xioTechnologies/Money-No-Object/RFID Coil Jig/Assembly Process Photos/CIMG1613.JPG

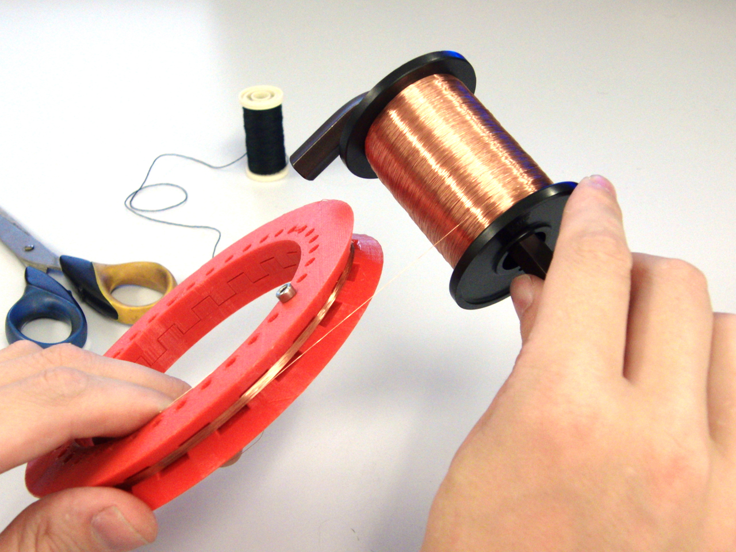
RFID Coil Jig/Assembly Process Photos/CIMG1613.JPG
