xioTechnologies/Money-No-Object/RFID Coil Jig/Assembly Process Photos/CIMG1606.JPG

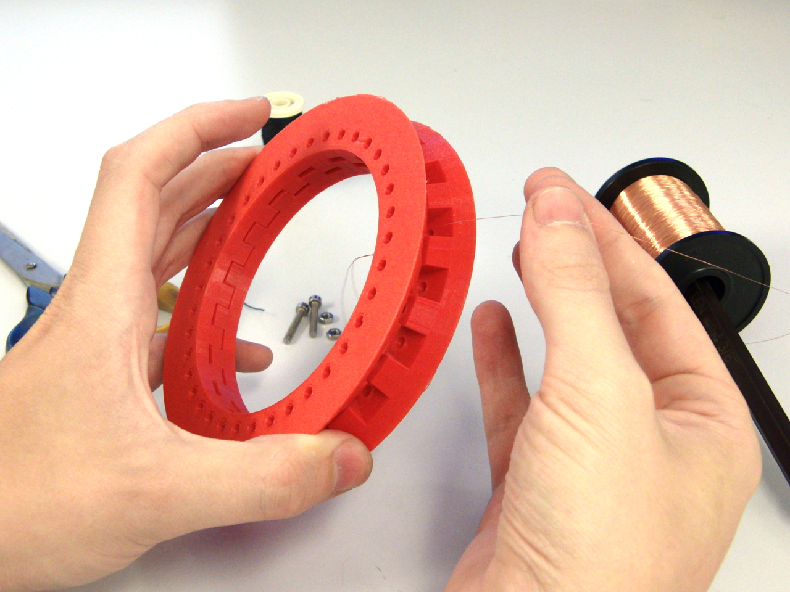
RFID Coil Jig/Assembly Process Photos/CIMG1606.JPG
