xioTechnologies/Money-No-Object/RFID Coil Jig/SolidWorks Screenshot.png

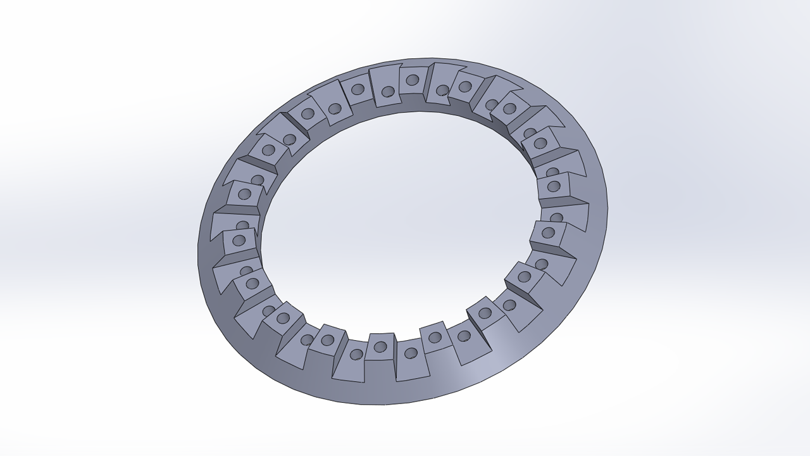
RFID Coil Jig/SolidWorks Screenshot.png
