xioTechnologies/Money-No-Object/RFID Coil Jig/RFID Coil Jig.SLDPRT

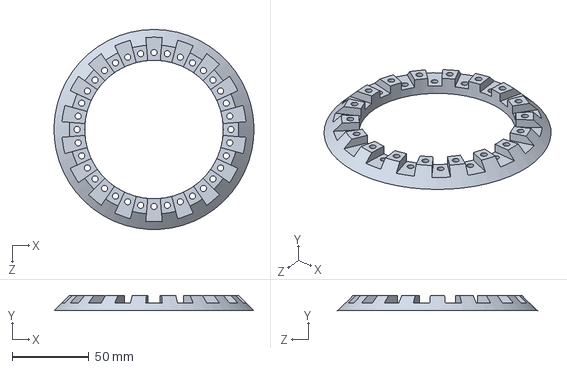
[picture p4: CAD file, 2014-08-11]
RFID Coil Jig/RFID Coil Jig.SLDPRT
129.9 x 10.0 x 130.0 mm
