xioTechnologies/Money-No-Object/(list of files, cad)

Other CAD files:
RFID Coil Jig/RFID Coil Jig.STL
