xioTechnologies/Money-No-Object/RFID Coil Jig/Assembly Process Photos/CIMG1603.JPG

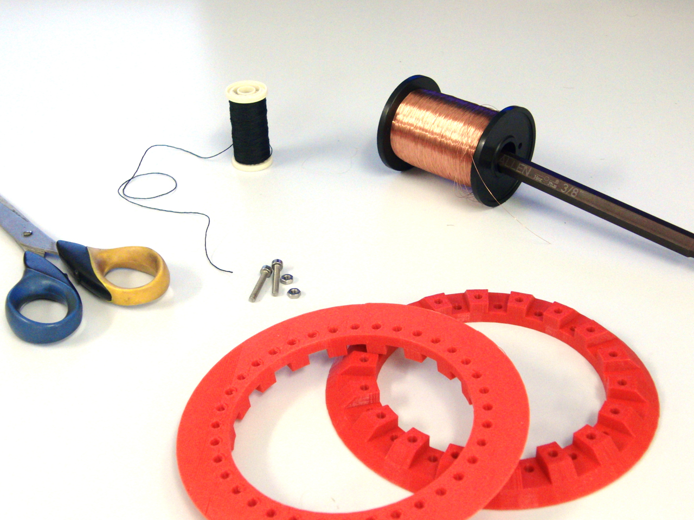
RFID Coil Jig/Assembly Process Photos/CIMG1603.JPG
