xioTechnologies/Money-No-Object/RFID Coil Jig/Assembly Process Photos/CIMG1605.JPG

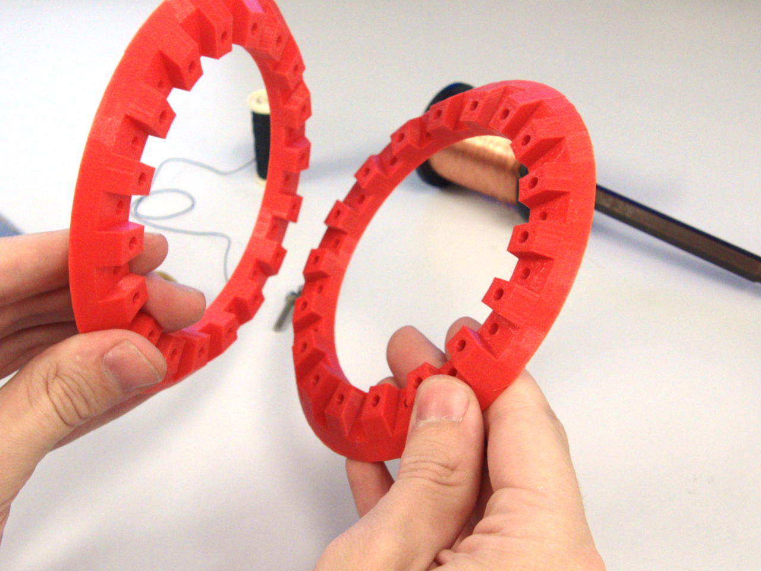
RFID Coil Jig/Assembly Process Photos/CIMG1605.JPG
