xioTechnologies/Money-No-Object/RFID Coil Jig/Assembly Process Photos/CIMG1609.JPG

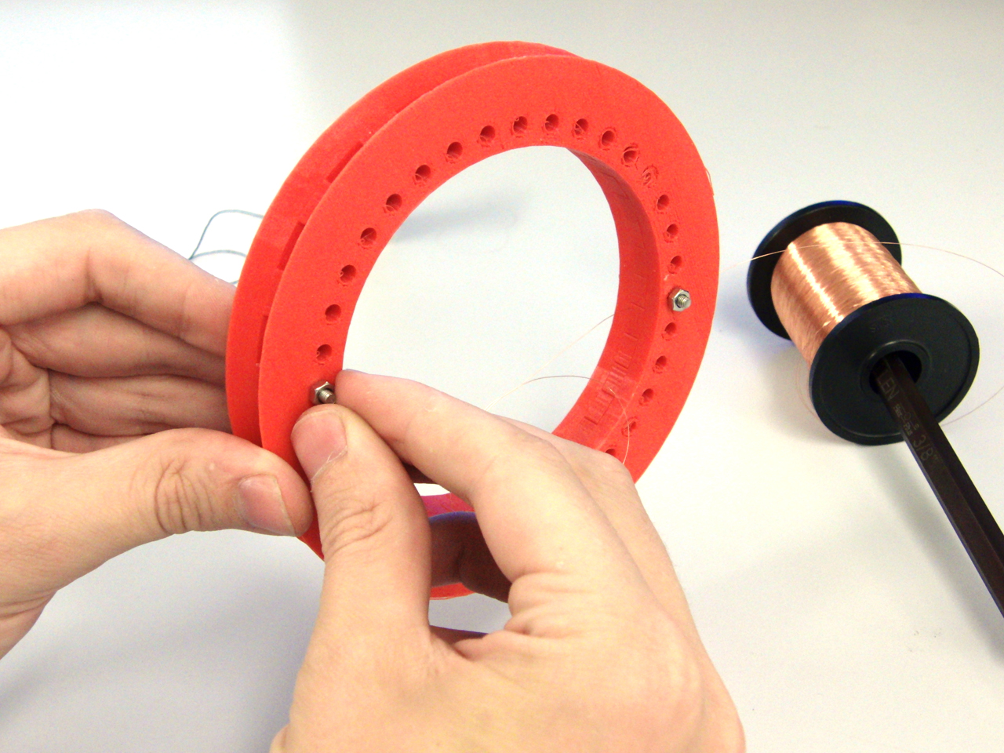
RFID Coil Jig/Assembly Process Photos/CIMG1609.JPG
