xioTechnologies/Money-No-Object/RFID Coil Jig/Assembly Process Photos/CIMG1616.JPG

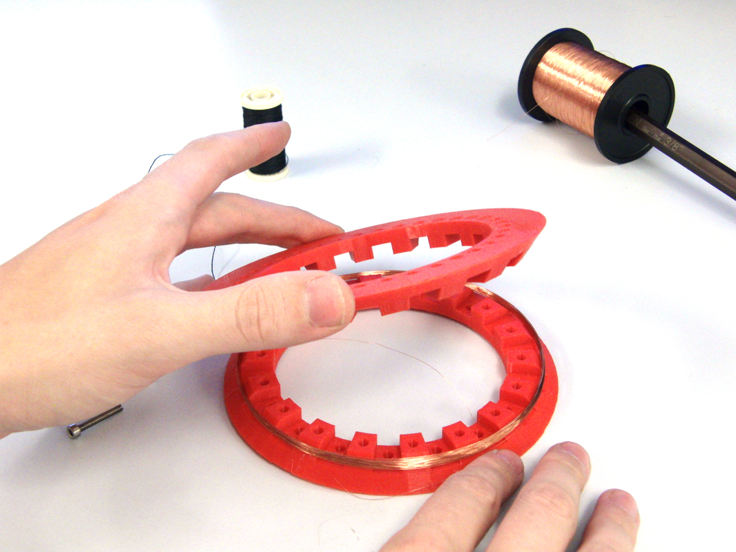
RFID Coil Jig/Assembly Process Photos/CIMG1616.JPG
