xioTechnologies/Money-No-Object/RFID Coil Jig/Assembly Process Photos/CIMG1617.JPG

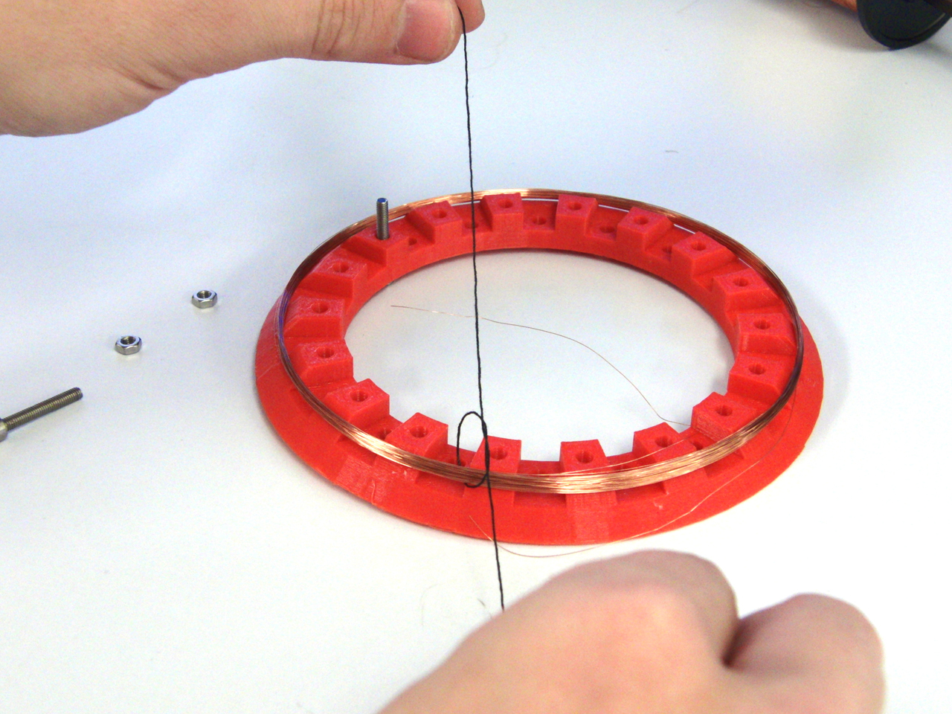
RFID Coil Jig/Assembly Process Photos/CIMG1617.JPG
