xioTechnologies/Money-No-Object/RFID Coil Jig/Assembly Process Photos/CIMG1619.JPG

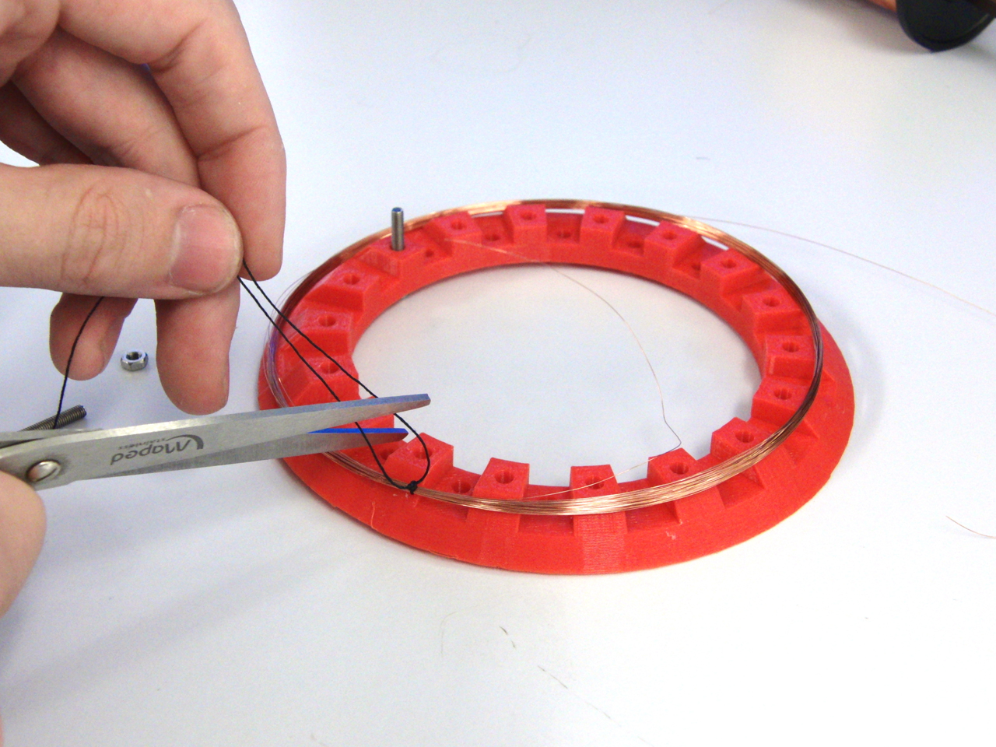
RFID Coil Jig/Assembly Process Photos/CIMG1619.JPG
