xioTechnologies/Money-No-Object/RFID Coil Jig/Assembly Process Photos/CIMG1623.JPG

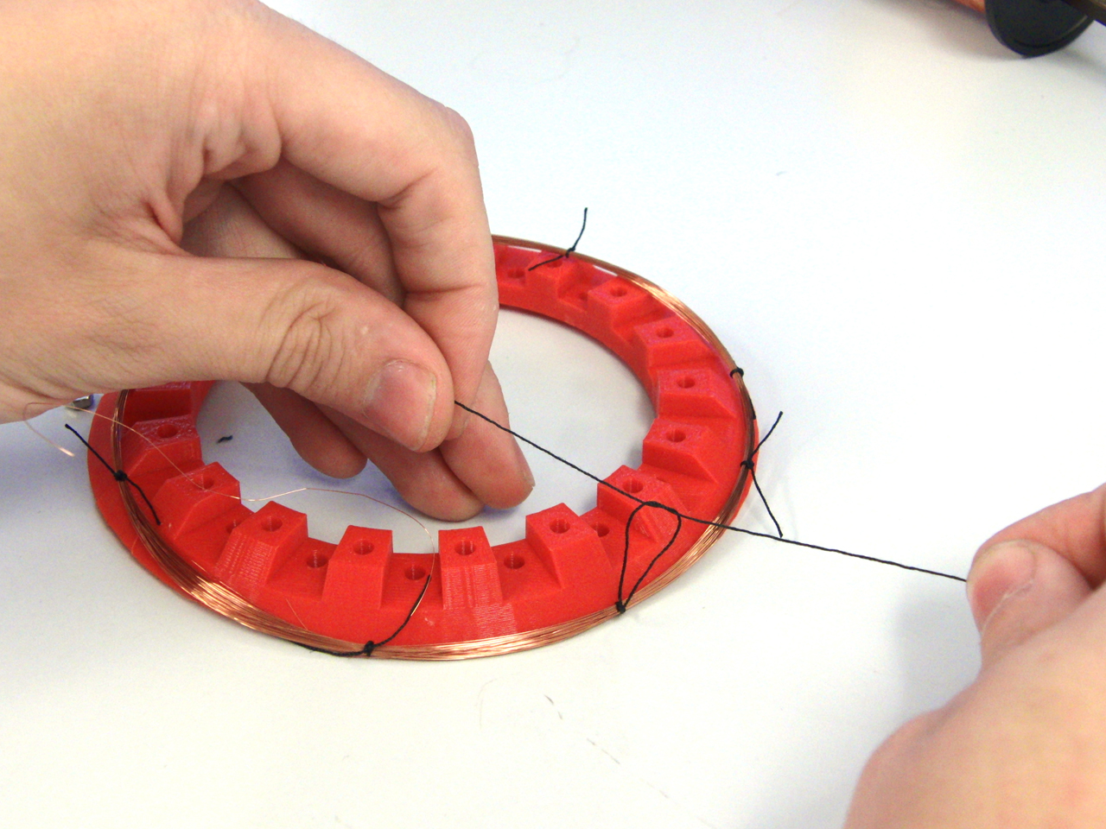
RFID Coil Jig/Assembly Process Photos/CIMG1623.JPG
