xioTechnologies/Money-No-Object/RFID Coil Jig/Assembly Process Photos/CIMG1625.JPG

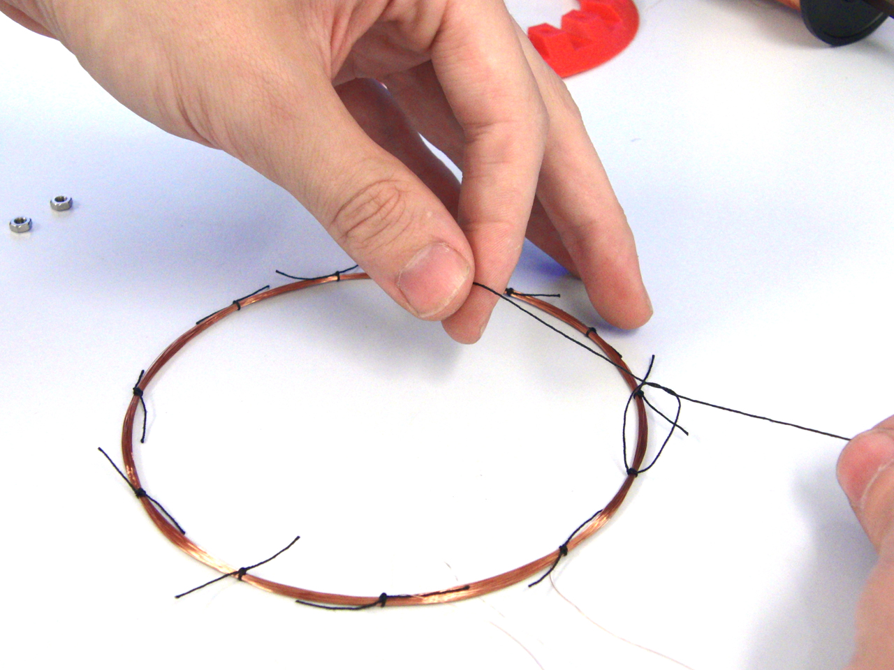
RFID Coil Jig/Assembly Process Photos/CIMG1625.JPG
