xioTechnologies/Money-No-Object/RFID Coil Jig/Assembly Process Photos/CIMG1631.JPG

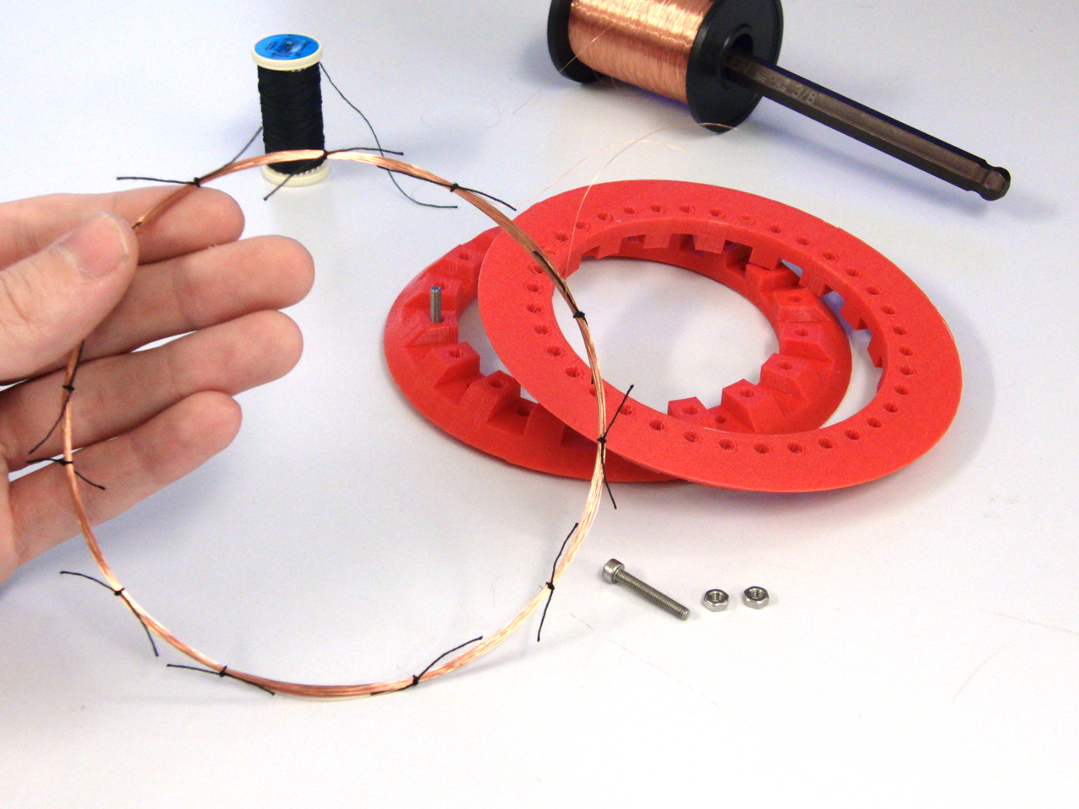
RFID Coil Jig/Assembly Process Photos/CIMG1631.JPG
