xioTechnologies/Money-No-Object/RFID Coil Jig/Assembly Process Photos/CIMG1632.JPG

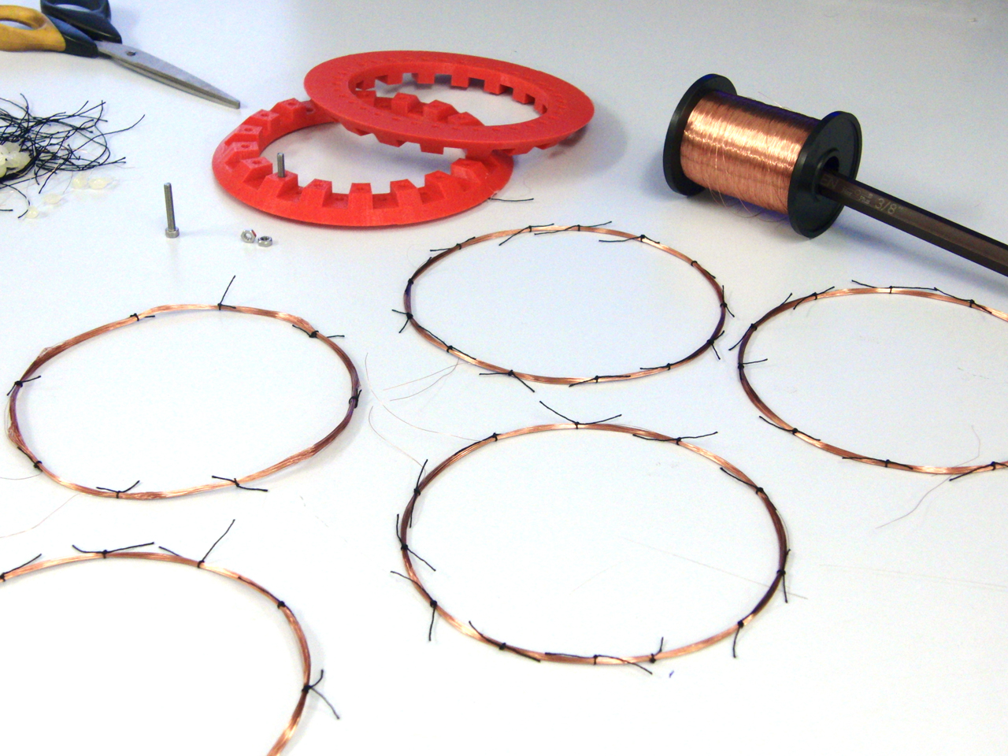
RFID Coil Jig/Assembly Process Photos/CIMG1632.JPG
