xioTechnologies/Money-No-Object/RFID Coil Jig/Assembly Process Photos/CIMG1639.JPG

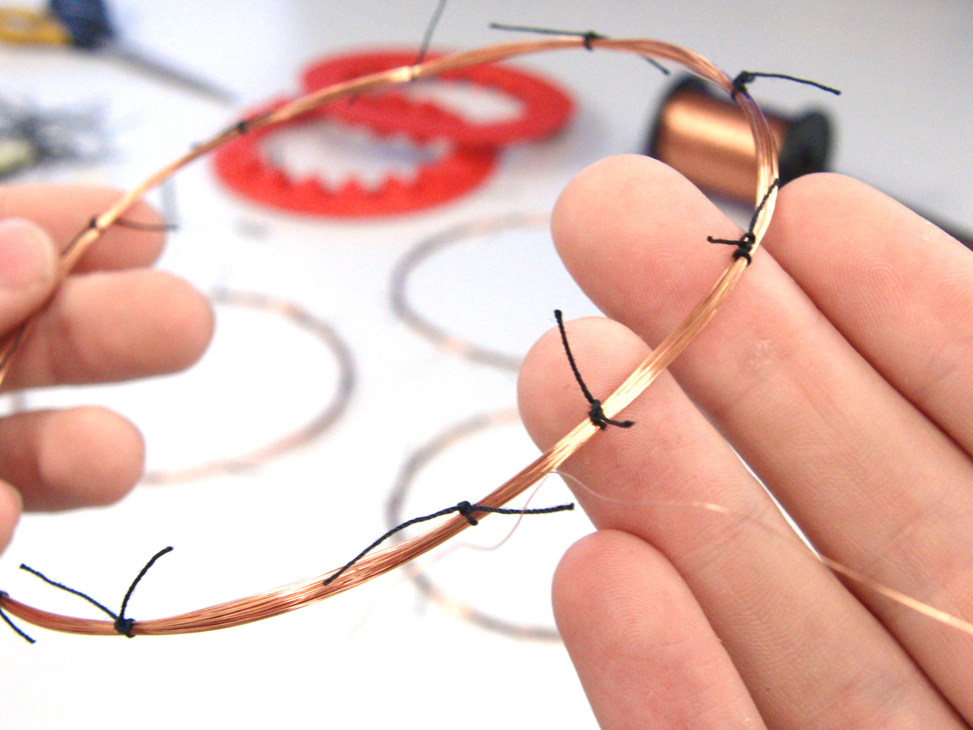
RFID Coil Jig/Assembly Process Photos/CIMG1639.JPG
