xioTechnologies/Money-No-Object/Wireless RIFID Reader PCB/Wireless RIFID Reader Schematic.pdf

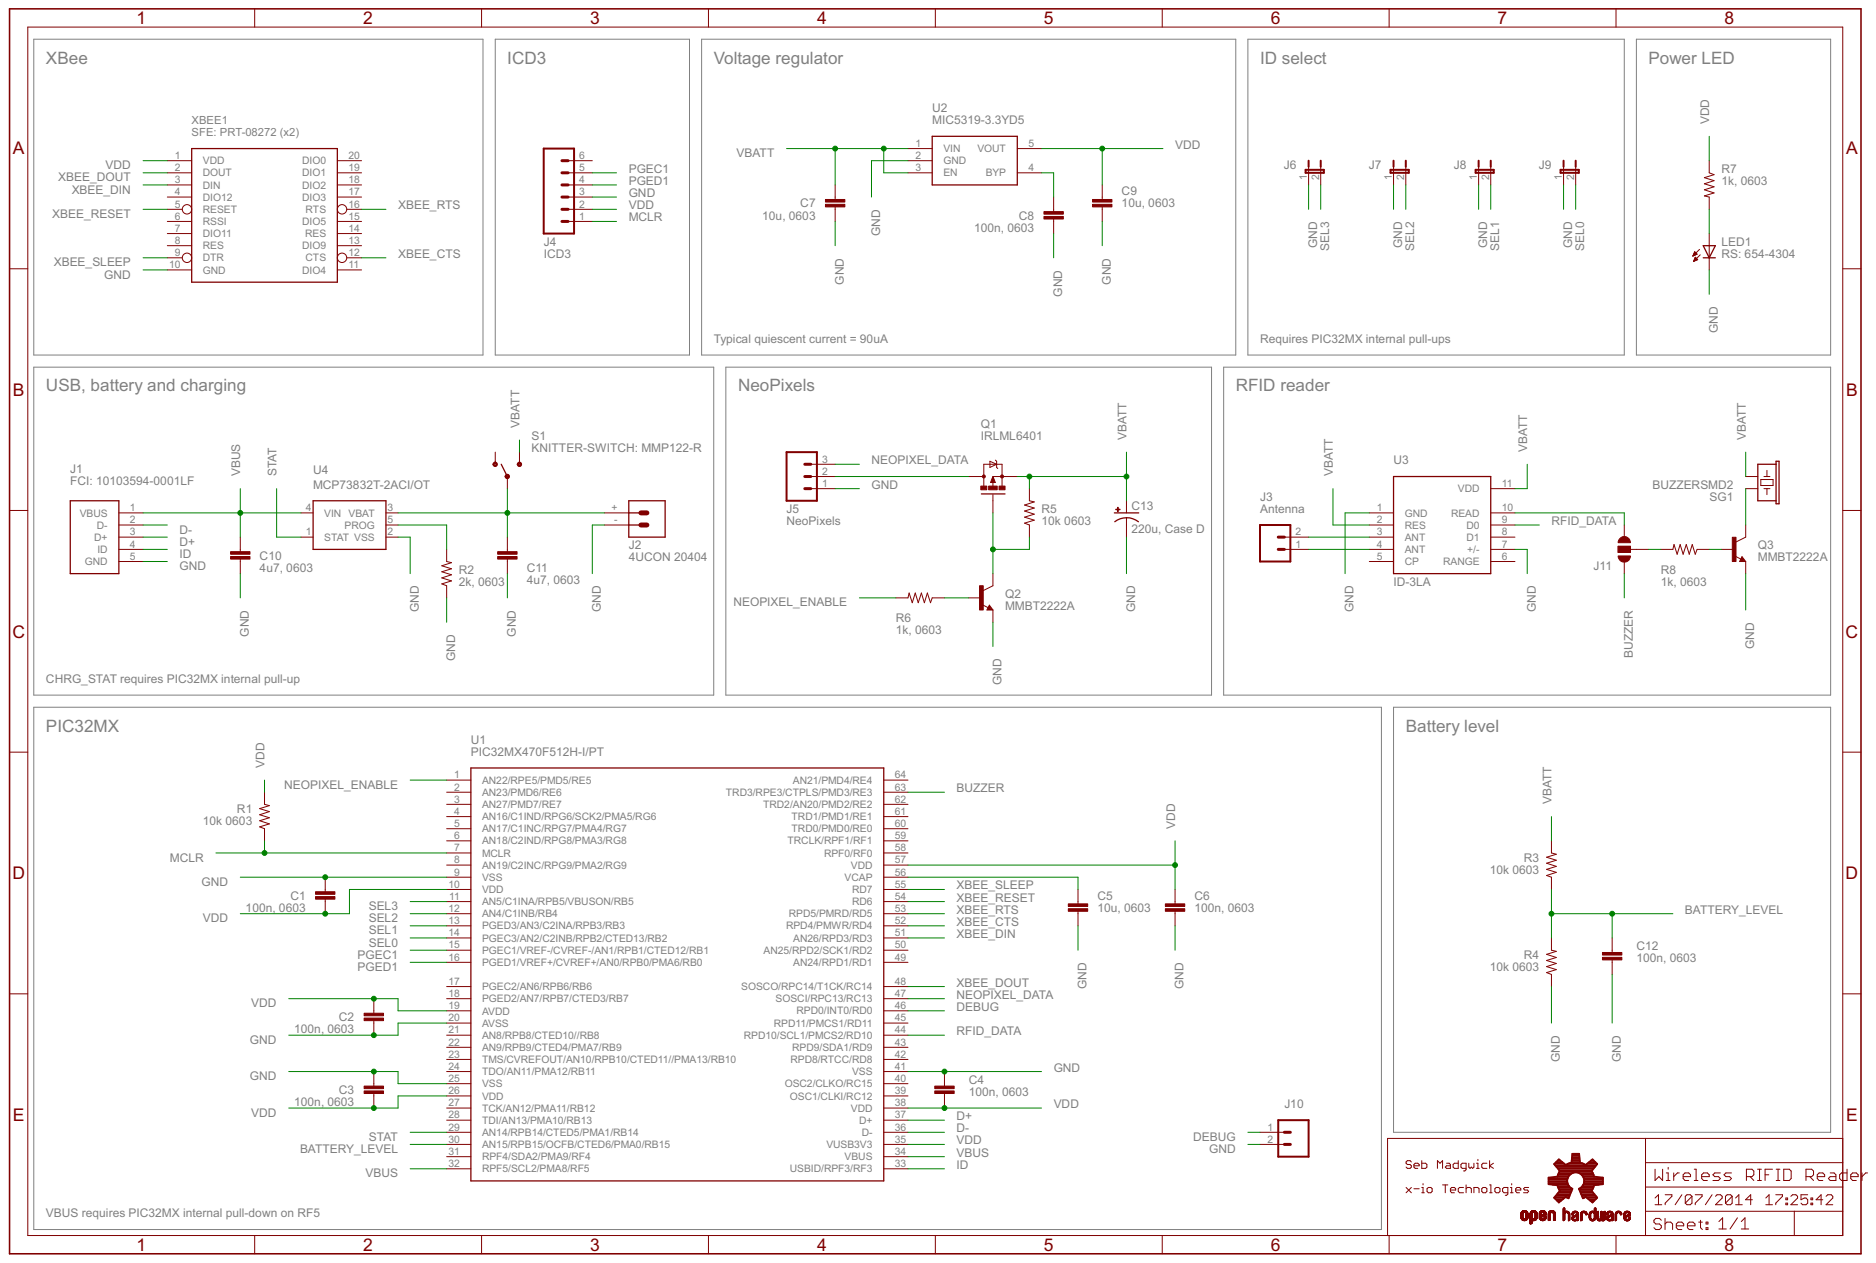
[picture p16: page 1]

GND GND

Requires PIC32MX internal pull-ups

USB, battery and charging

CHRG_STAT requires PIC32MX internal pull-up

VBUS requires PIC32MX internal pull-down on RF5
