xioTechnologies/Money-No-Object/Wireless RIFID Reader PCB/Wireless RIFID Reader.brd

## EAGLE design Wireless RIFID Reader PCB/Wireless RIFID Reader.brd (2014-07-17)

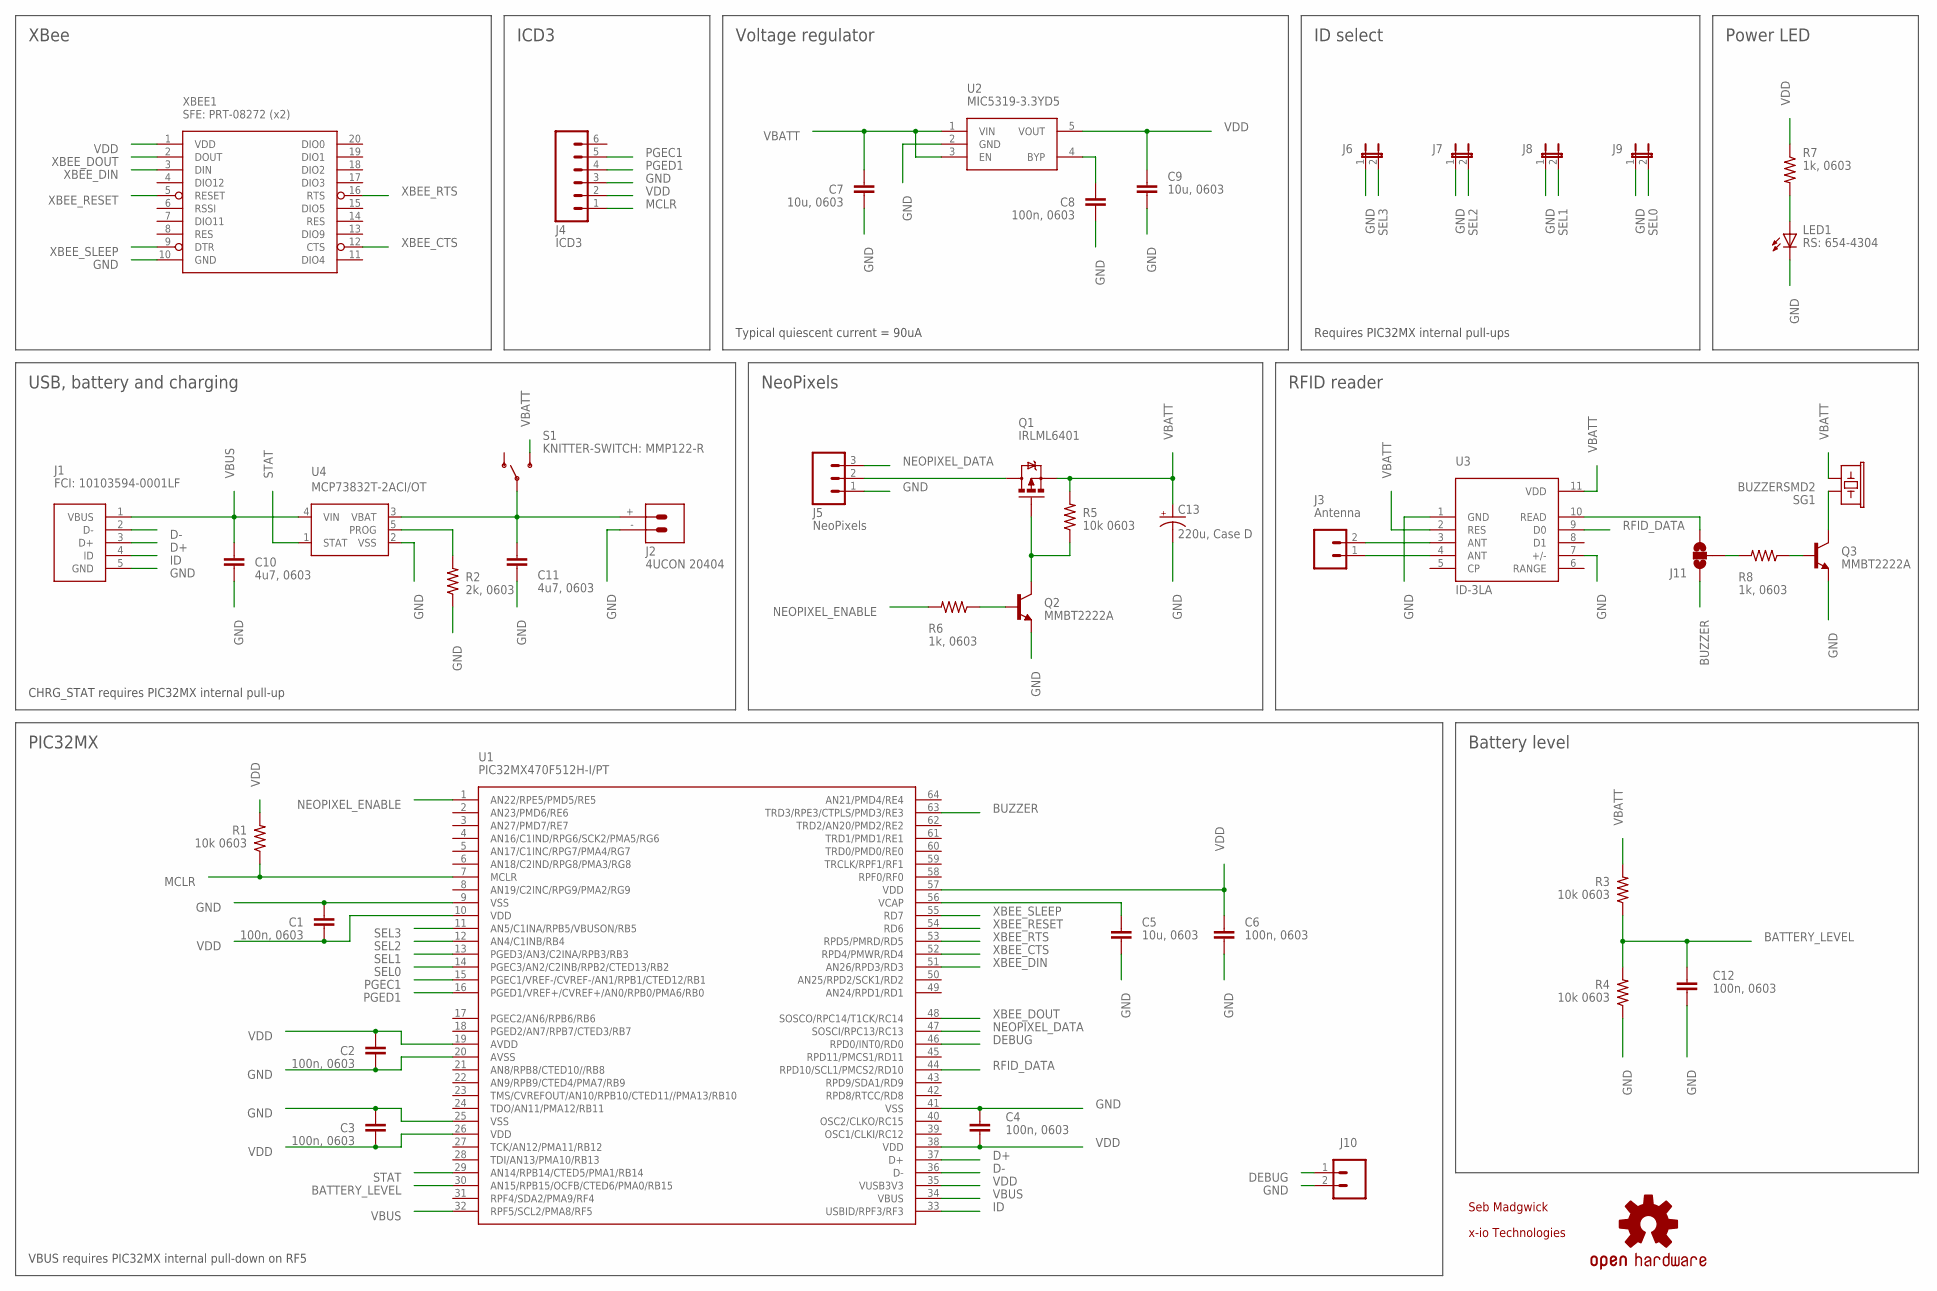
[picture p17: schematic Wireless RIFID Reader.sch]

Parts:
C1, C2, C3, C4, C6, C8, C12: 100n, 0603; 0402-CAP
C5, C7, C9: 10u, 0603; 0402-CAP
C10, C11: 4u7, 0603; 0402-CAP
C13: 220u, Case D; SMC_D
J1: FCI: 10103594-0001LF; 10103594-0001LF
J2: 4UCON 20404; JST-R/A
J3: Antenna; 1X02
J4: ICD3; 1X06_NO_SILK
J5: NeoPixels; 1X03
J6, J7, J8, J9: JUMPER-2SMD-NO; SJ_2S-NO
J10: M02PTH; 1X02
J11: JUMPER-PAD-3-NOFULL_BOX_SILK; PAD-JUMPER-3-NO_YES_SILK_FULL_BOX
LED1: RS: 654-4304; LED-0603
LOGO1: OSHW-LOGOM; OSHW-LOGO-M
Q1: IRLML6401; SOT23
Q2, Q3: MMBT2222A; SOT23-3
R1, R3, R4, R5: 10k 0603; 0402-RES
R2: 2k, 0603; 0402-RES
R6, R7, R8: 1k, 0603; 0402-RES
S1: KNITTER-SWITCH: MMP122-R; MMP122-R
SG1: BUZZERSMD2; BUZZER-CCV
U1: PIC32MX470F512H-I/PT; TQFP64-10X10
U2: MIC5319-3.3YD5; SOT23-5
U3: ID-3LA
U4: MCP73832T-2ACI/OT; SOT23-5
XBEE1: SFE: PRT-08272 (x2); XBEE-1

Connections:
BATTERY_LEVEL: C12.1, R3.1, R4.2, U1.30 (AN15/RPB15/OCFB/CTED6/PMA0/RB15)
BUZZER: J11.1, U1.63 (TRD3/RPE3/CTPLS/PMD3/RE3)
D+: J1.3 (D+), U1.37 (D+)
D-: J1.2 (D-), U1.36 (D-)
DEBUG: J10.1, U1.46 (RPD0/INT0/RD0)
GND: C1.1, C2.2, C3.1, C4.1, C5.2, C6.2, C7.2, C8.2, C9.2, C10.2, C11.2, C12.2, C13.-, J1.5 (GND), J2.-, J4.3, J5.1, J6.1, J7.1, J8.1, J9.1, J10.2, LED1.C, Q2.2 (E), Q3.2 (E), R2.1, R4.1, U1.9 (VSS), U1.20 (AVSS), U1.25 (VSS), U1.41 (VSS), U2.2 (GND), U3.1 (GND), U3.7 (+/-), U4.2 (VSS), XBEE1.10 (GND)
ID: J1.4 (ID), U1.33 (USBID/RPF3/RF3)
MCLR: J4.1, R1.1, U1.7 (MCLR)
unnamed: J3.2, U3.3 (ANT)
unnamed: J3.1, U3.4 (ANT)
unnamed: C11.1, J2.+, S1.2, U4.3 (VBAT)
unnamed: J5.2, Q1.3 (D)
unnamed: Q1.1 (G), Q2.3 (C), R5.1
unnamed: Q2.1 (B), R6.1
unnamed: C8.1, U2.4 (BYP)
unnamed: R2.2, U4.5 (PROG)
unnamed: LED1.A, R7.2
unnamed: Q3.1 (B), R8.1
unnamed: C5.1, U1.56 (VCAP)
unnamed: Q3.3 (C), SG1.+ (1)
unnamed: J11.3, U3.10 (READ)
unnamed: J11.2, R8.2
NEOPIXEL_DATA: J5.3, U1.47 (SOSCI/RPC13/RC13)
NEOPIXEL_ENABLE: R6.2, U1.1 (AN22/RPE5/PMD5/RE5)
PGEC1: J4.5, U1.15 (PGEC1/VREF-/CVREF-/AN1/RPB1/CTED12/RB1)
PGED1: J4.4, U1.16 (PGED1/VREF+/CVREF+/AN0/RPB0/PMA6/RB0)
RFID_DATA: U1.44 (RPD10/SCL1/PMCS2/RD10), U3.9 (D0)
SEL0: J9.2, U1.14 (PGEC3/AN2/C2INB/RPB2/CTED13/RB2)
SEL1: J8.2, U1.13 (PGED3/AN3/C2INA/RPB3/RB3)
SEL2: J7.2, U1.12 (AN4/C1INB/RB4)
SEL3: J6.2, U1.11 (AN5/C1INA/RPB5/VBUSON/RB5)
STAT: U1.29 (AN14/RPB14/CTED5/PMA1/RB14), U4.1 (STAT)
VBATT: C7.1, C13.+, Q1.2 (S), R3.2, R5.2, S1.3, SG1.- (2), U2.1 (VIN), U2.3 (EN), U3.2 (RES), U3.11 (VDD)
VBUS: C10.1, J1.1 (VBUS), U1.32 (RPF5/SCL2/PMA8/RF5), U1.34 (VBUS), U4.4 (VIN)
VDD: C1.2, C2.1, C3.2, C4.2, C6.1, C9.1, J4.2, R1.2, R7.1, U1.10 (VDD), U1.19 (AVDD), U1.26 (VDD), U1.35 (VUSB3V3), U1.38 (VDD), U1.57 (VDD), U2.5 (VOUT), XBEE1.1 (VDD)
XBEE_CTS: U1.52 (RPD4/PMWR/RD4), XBEE1.12 (CTS)
XBEE_DIN: U1.51 (AN26/RPD3/RD3), XBEE1.3 (DIN)
XBEE_DOUT: U1.48 (SOSCO/RPC14/T1CK/RC14), XBEE1.2 (DOUT)
XBEE_RESET: U1.54 (RD6), XBEE1.5 (RESET)
XBEE_RTS: U1.53 (RPD5/PMRD/RD5), XBEE1.16 (RTS)
XBEE_SLEEP: U1.55 (RD7), XBEE1.9 (DTR)

Notes on the sheet:
XBee
Battery level
USB, battery and charging
Voltage regulator
CHRG_STAT requires PIC32MX internal pull-up
Seb Madgwick
x-io Technologies
Typical quiescent current = 90uA
PIC32MX
RFID reader
NeoPixels
ID select
Requires PIC32MX internal pull-ups
ICD3
VBUS requires PIC32MX internal pull-down on RF5
Power LED

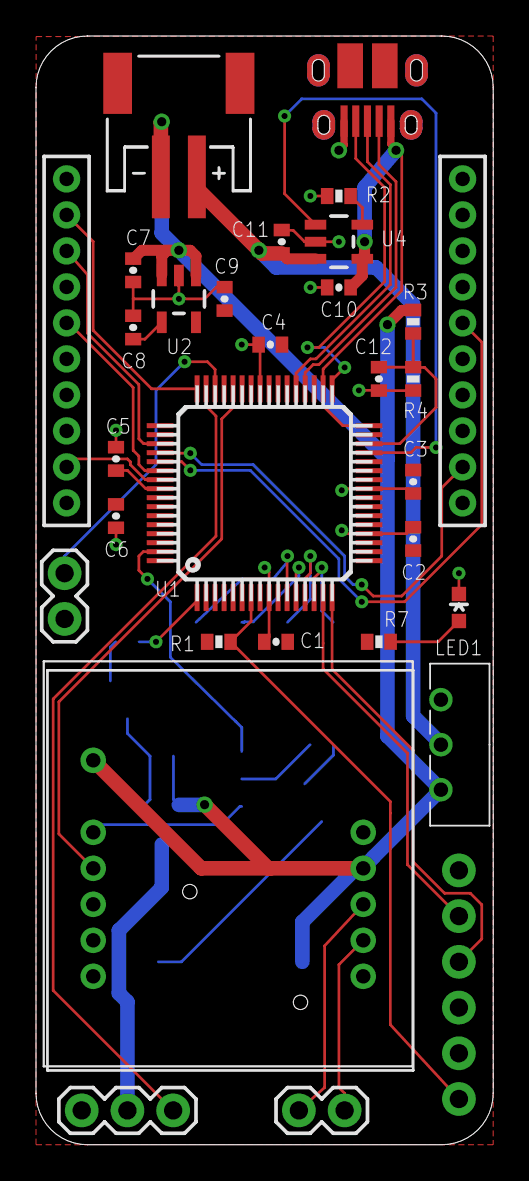
[picture p18: board Wireless RIFID Reader.brd from above]

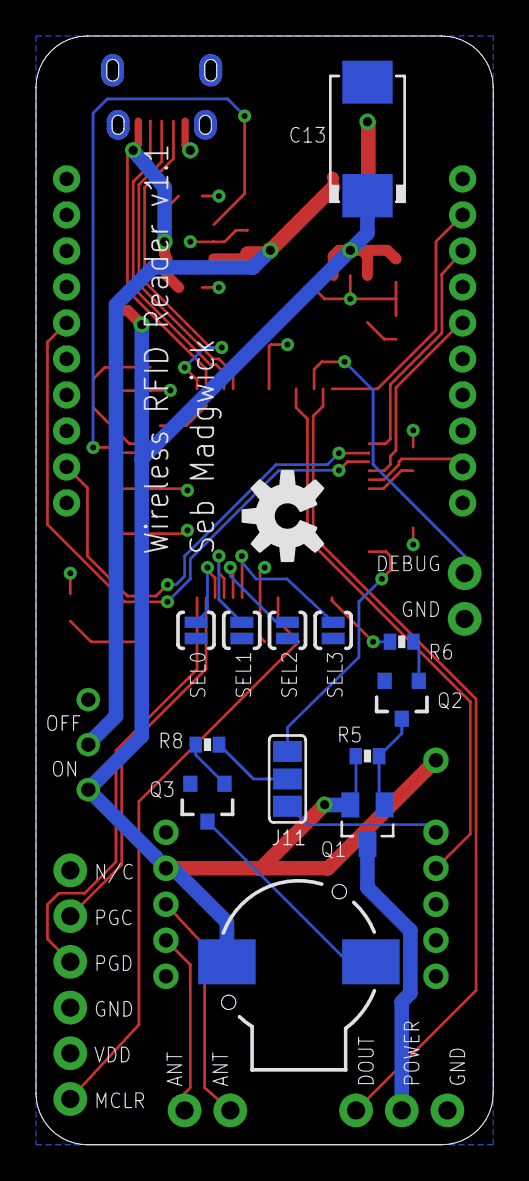
[picture p19: board Wireless RIFID Reader.brd from below]

Board: 2 copper layers, 25.4 x 61.6 mm, 44 parts (14 on the bottom side), 41 nets.
