xioTechnologies/Money-No-Object/Wireless RIFID Reader Firmware/SleepTimer/SleepTimer.h

/*
 * File:   SleepTimer.h
 * Author: Seb Madgwick
 */

#ifndef SLEEP_TIMER_H
#define SLEEP_TIMER_H

//------------------------------------------------------------------------------
// Function declarations

void SleepTimerInitialise(void);
void SleepTimerDoTasks(void);
void SleepTimerReset(void);

#endif

//------------------------------------------------------------------------------
// End of file
