xioTechnologies/Money-No-Object/Wireless RIFID Reader Firmware/FirmwareVersion.h

/*
 * File:   FirmwareVersion.h
 * Author: Seb Madgwick
 */

#ifndef FIRMWARE_VERSION_H
#define FIRMWARE_VERSION_H

//------------------------------------------------------------------------------
// Definitions

#define FIRMWARE_VERSION "v1.1"

#endif

//------------------------------------------------------------------------------
// End of file
