xioTechnologies/Money-No-Object/(commit log)

2014-07-08 Add PCB files
    [Wireless RIFID Reader.brd, Wireless RIFID Reader.sch]
2014-07-17 Commit PCB v1.1 files
    [Wireless RIFID Reader.brd, Wireless RIFID Reader.sch]
2014-08-11 Add RFID Coil Jig files
    [RFID Coil Jig.SLDPRT, RFID Coil Jig.STL]
2014-08-12 Add Wireless RIFID Reader Console files
